LucasTor/can-cluster/start_cluster.py

import os
from concurrent.futures import ThreadPoolExecutor

from can_helper import read_can, log_realtime
from gpio_helper import read_io
from cluster import run_cluster
from model import SensorState

if __name__ == '__main__':
    state = SensorState()

    ex = ThreadPoolExecutor(max_workers=3, thread_name_prefix="ftcan")
    can_reader = ex.submit(read_can, state=state)
    io_reader = ex.submit(read_io, state=state)

    # Discovery logger for the FTCAN real-time broadcast ([canrt] in the journal).
    # On by default while we map the fan/2-step/output signals; set CAN_DEBUG=false
    # in the launcher to turn it off later.
    if os.environ.get('CAN_DEBUG', 'true').lower() == 'true':
        ex.submit(log_realtime)

    run_cluster(state)
