LucasTor/can-cluster/(commit log)

2025-09-01 feat: add can filter
2025-09-04 fix: shift light adjustments
    [cluster.py]
2025-09-15 fix: changes to cluster
    [cluster.py]
2025-09-19 advanced can
    [dump.txt]
